kfeng8021-spec/dase7503_robot/maps/before_after_compare.png

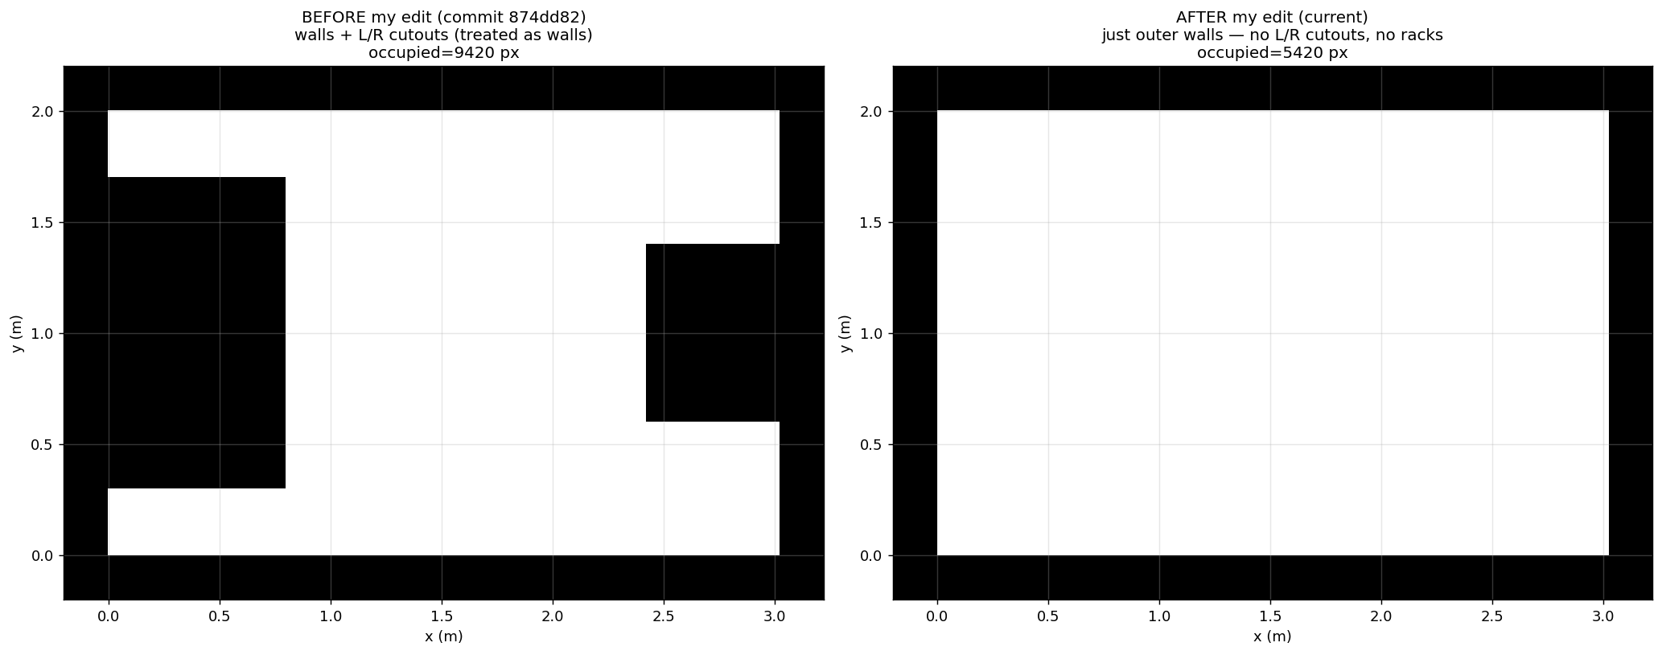
maps/before_after_compare.png
