kfeng8021-spec/dase7503_robot/maps/cad_v3_clean.png

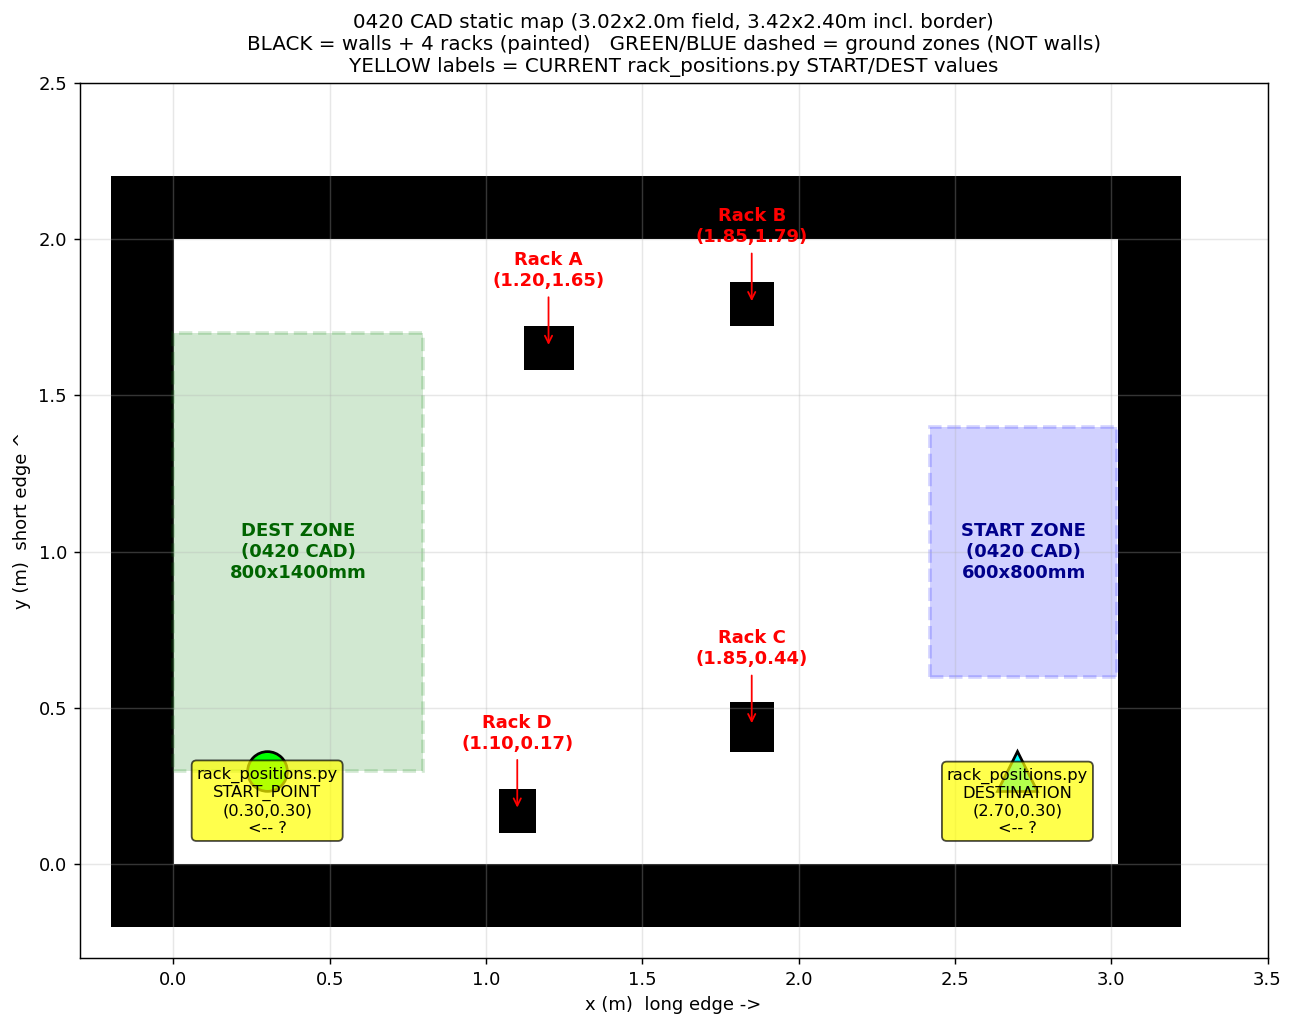
maps/cad_v3_clean.png
