kfeng8021-spec/dase7503_robot/maps/cad_v3_fixed.png

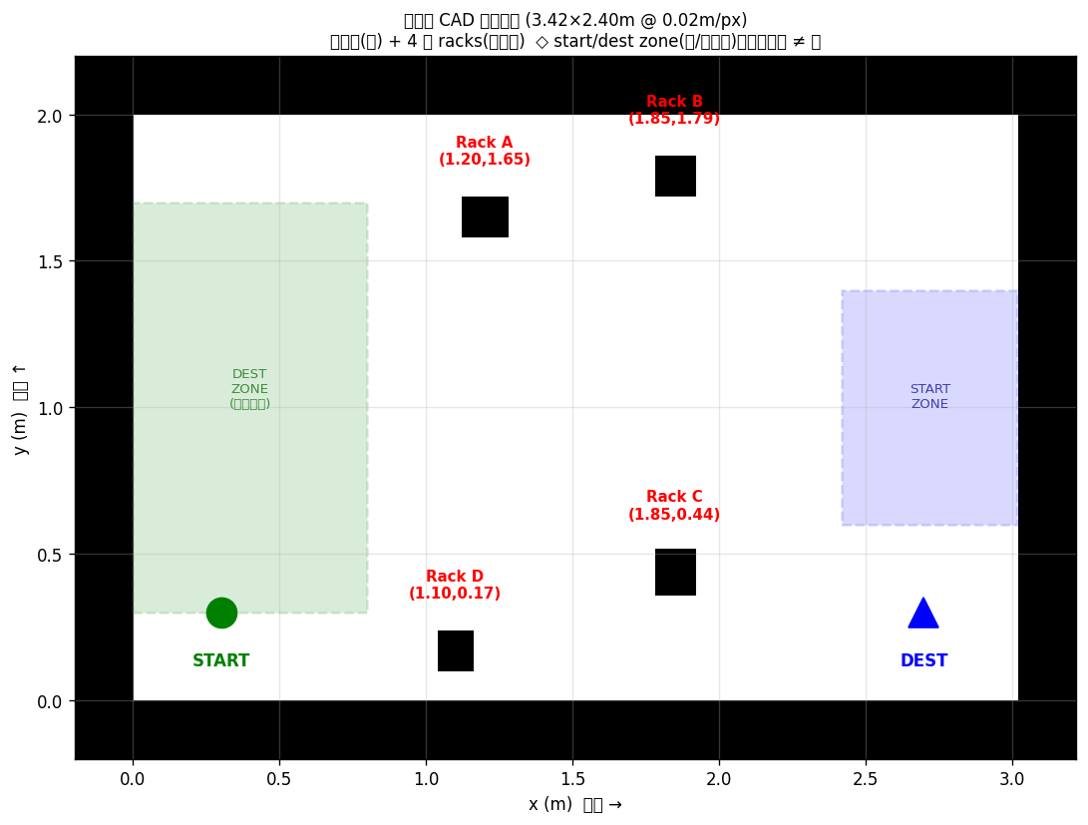
maps/cad_v3_fixed.png
