kfeng8021-spec/dase7503_robot/maps/cad_v4_no_rack_paint.png

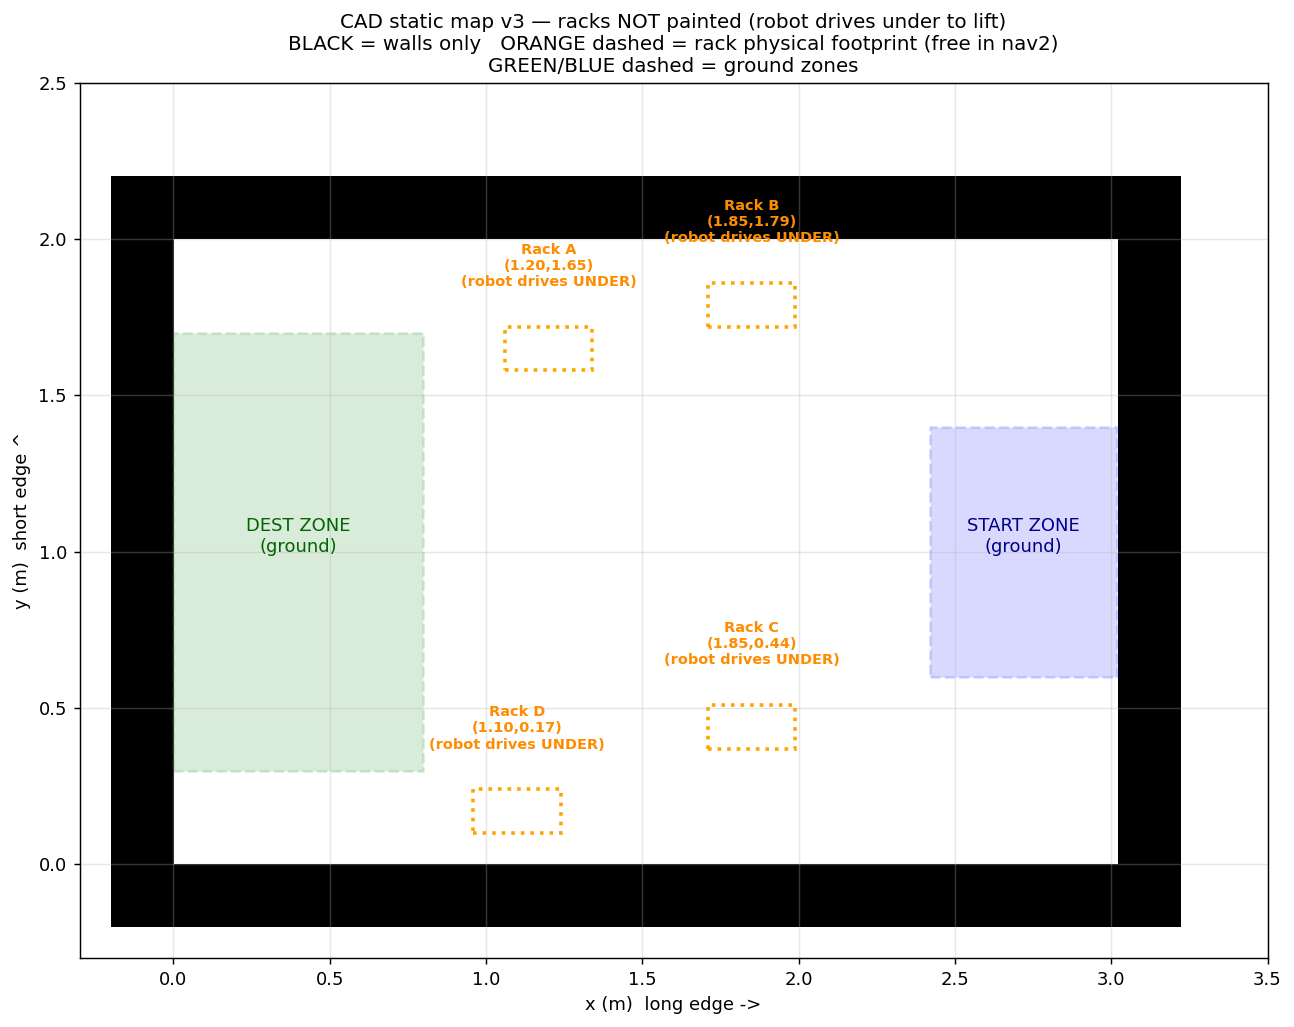
maps/cad_v4_no_rack_paint.png
