kfeng8021-spec/dase7503_robot/maps/cad_with_racks_overlay.png

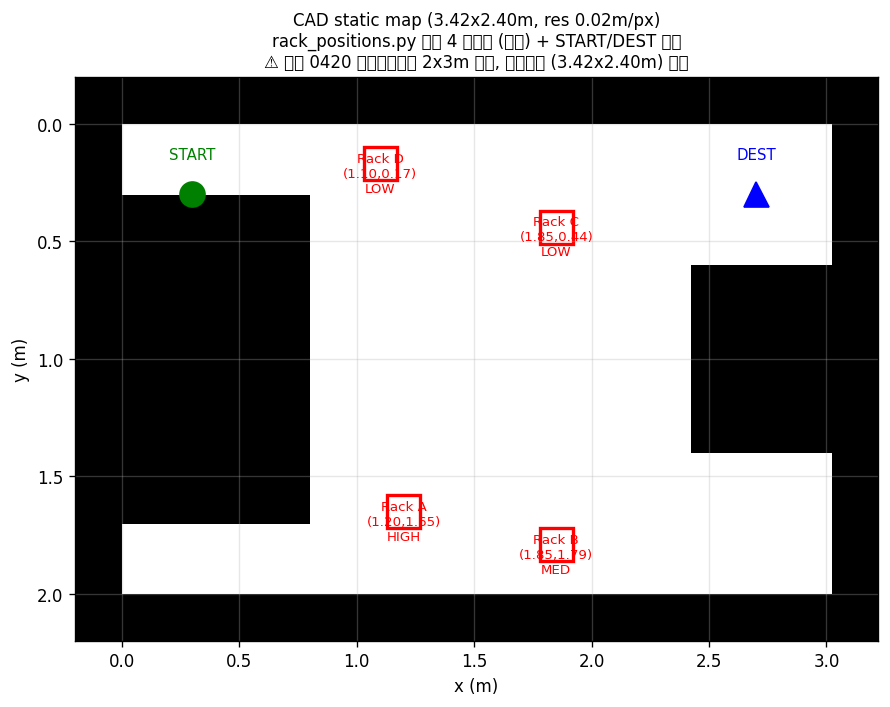
maps/cad_with_racks_overlay.png
