kfeng8021-spec/dase7503_robot/maps/cad_with_racks_v2.png

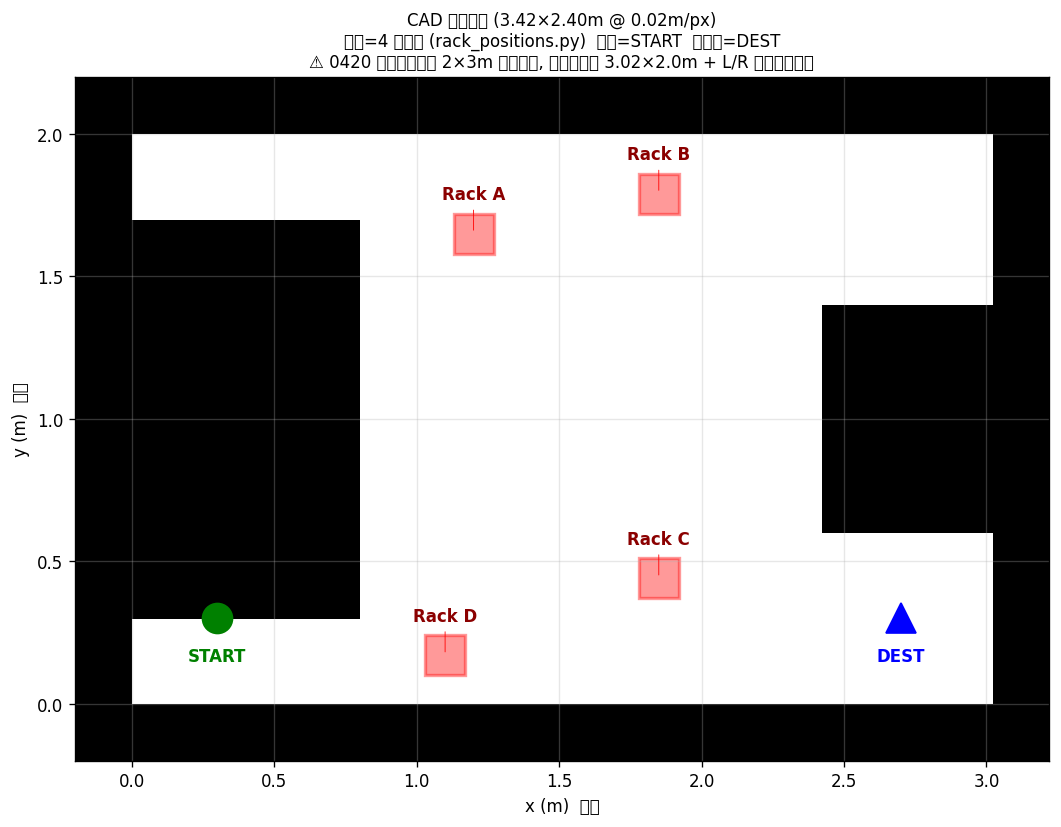
maps/cad_with_racks_v2.png
