kfeng8021-spec/dase7503_robot/maps/pi5_slam/pi5_slam_map.png

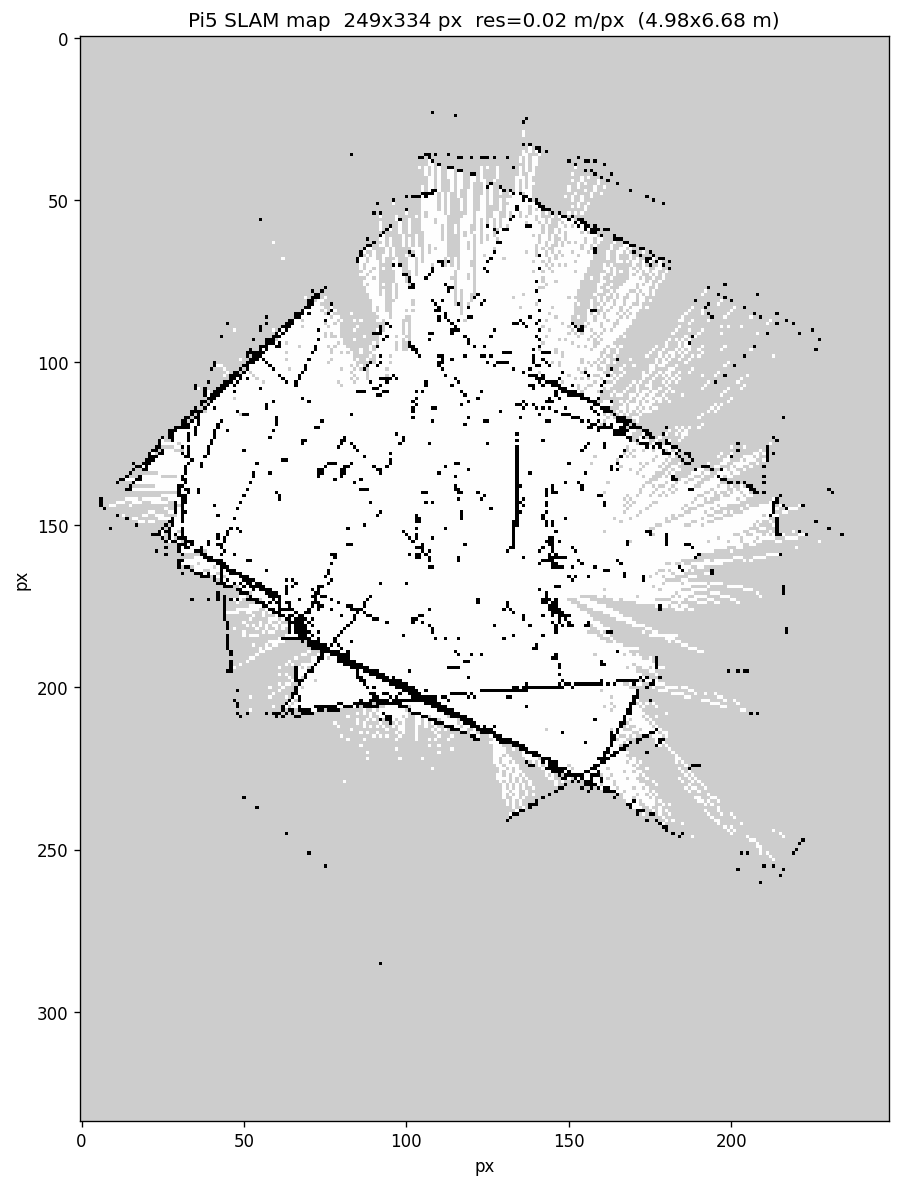
maps/pi5_slam/pi5_slam_map.png
