kfeng8021-spec/dase7503_robot/maps/pi5_slam/slam_vs_cad_with_racks.png

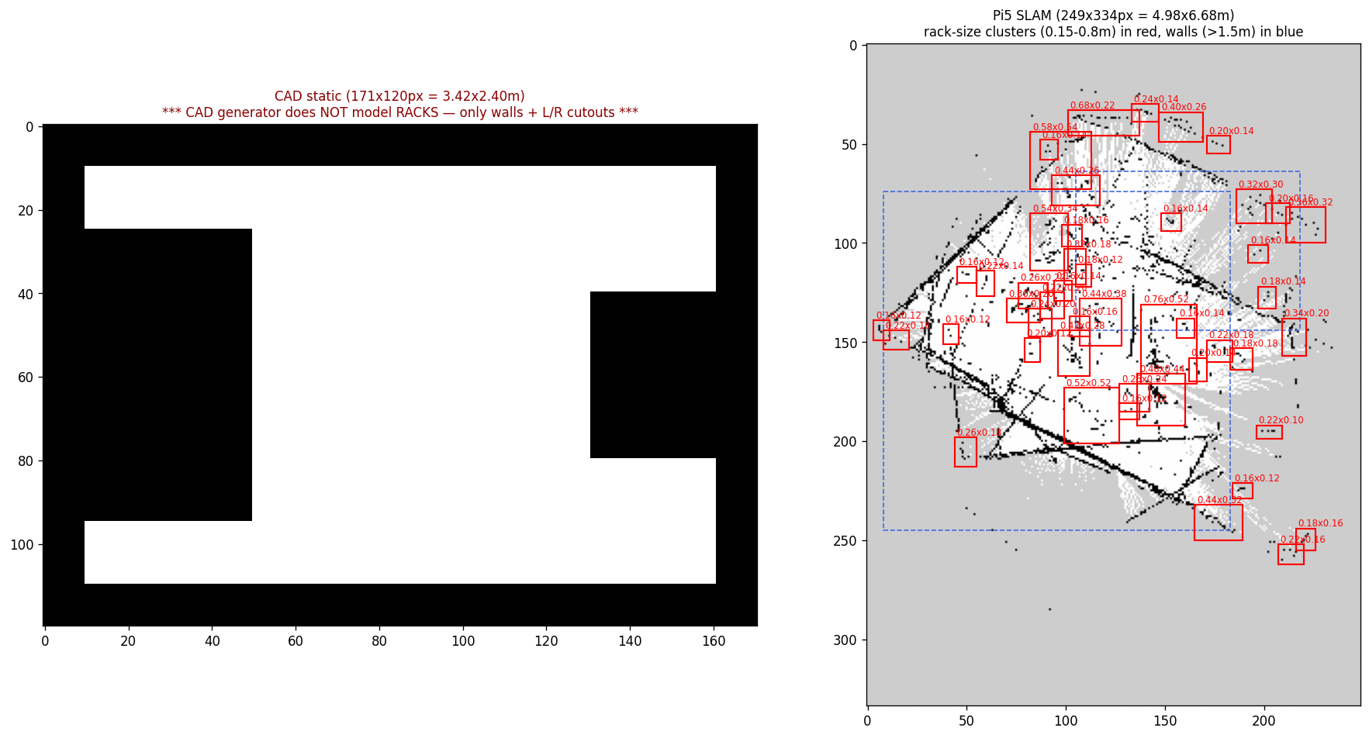
maps/pi5_slam/slam_vs_cad_with_racks.png
