kfeng8021-spec/dase7503_robot/maps/pi5_slam/slam_zoom_clusters.png

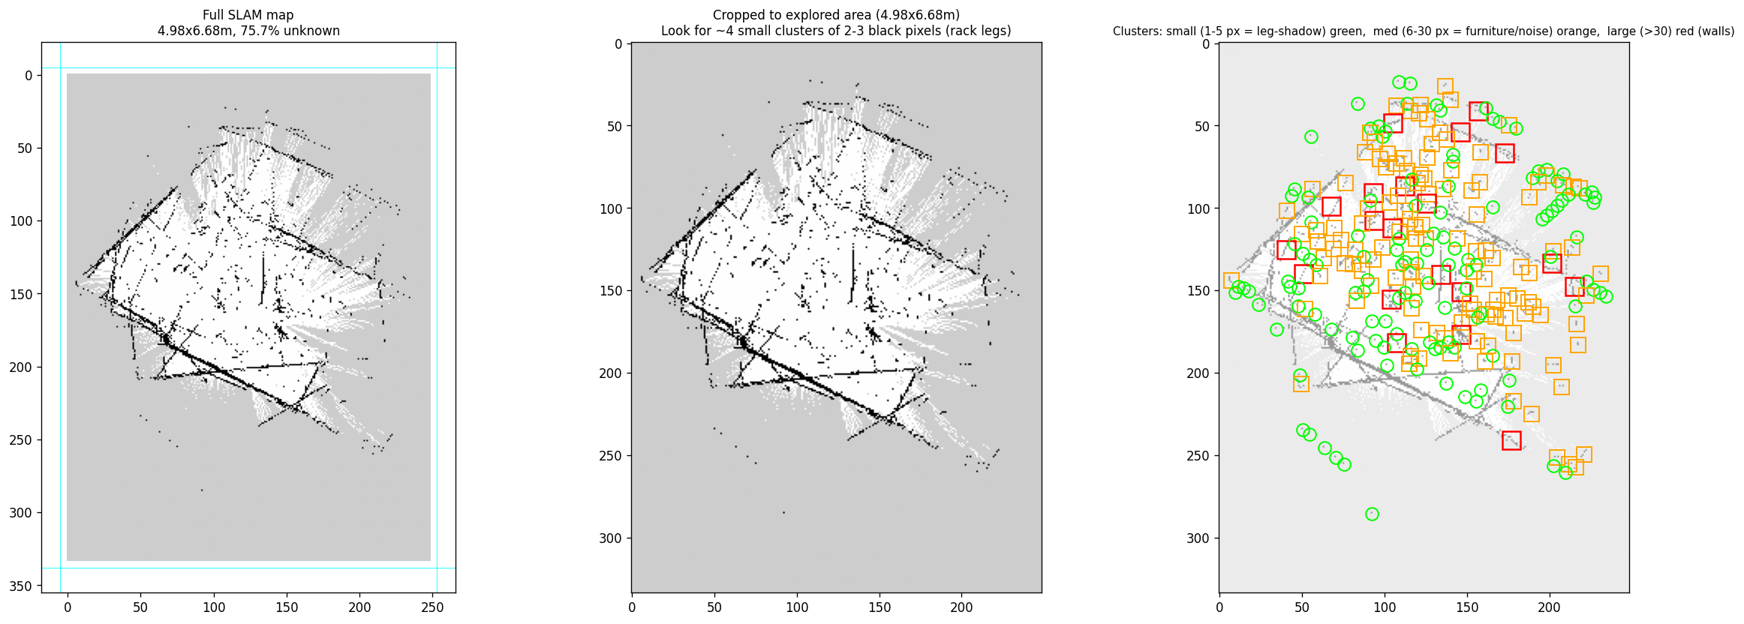
maps/pi5_slam/slam_zoom_clusters.png
