kfeng8021-spec/dase7503_robot/scripts/qr_codes/print_sheet.pdf

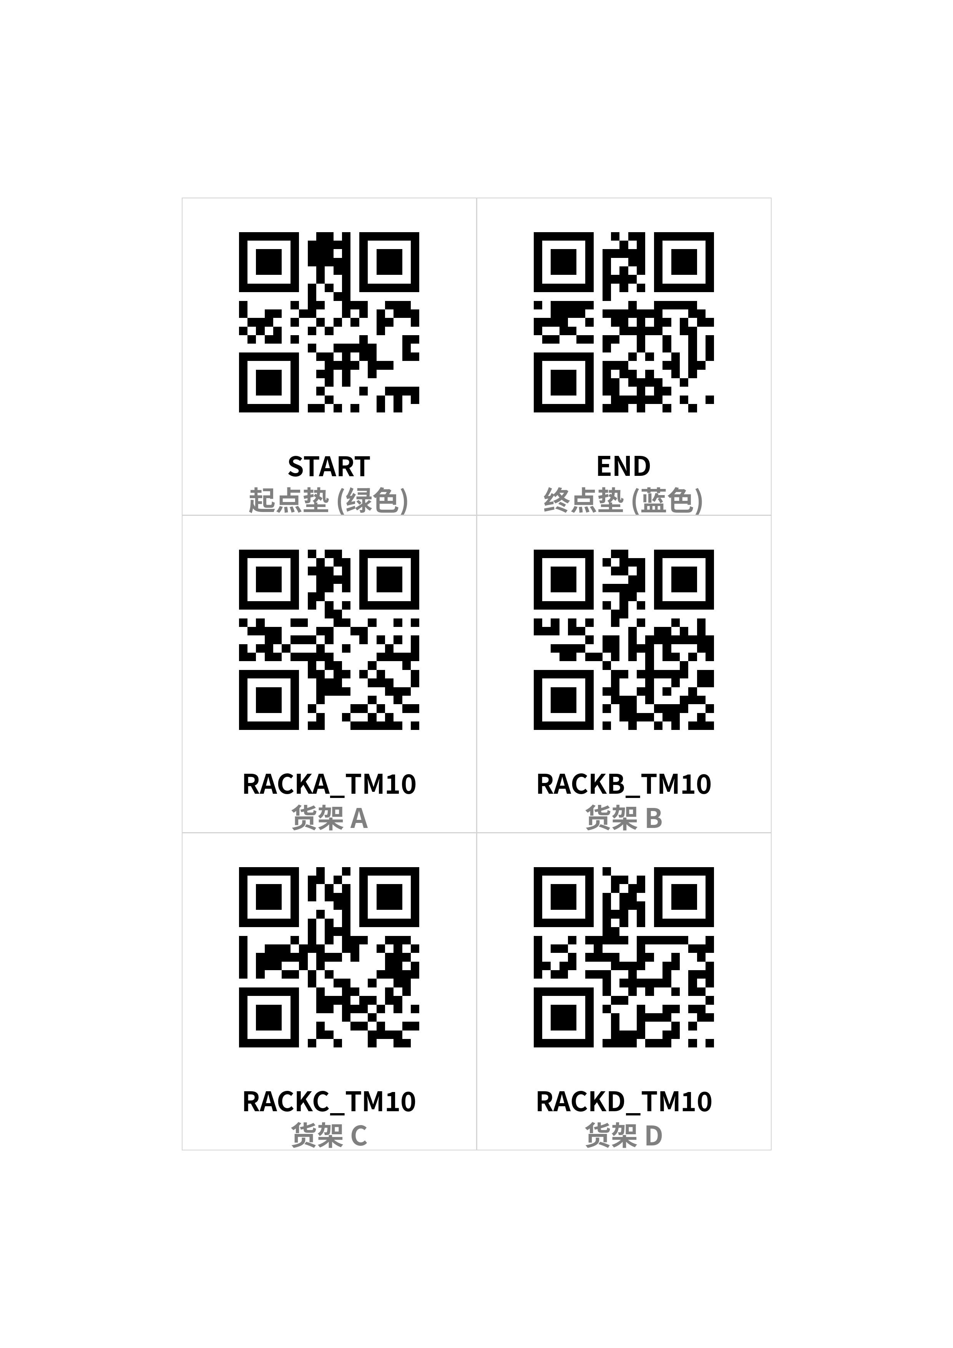
[picture p11: page 1]
