kfeng8021-spec/dase7503_robot/(commit log)

2026-04-21 Initial project scaffold
    - Full Plan 模块骨架: ROS 包 (mission_fsm + qr_scanner), ESP32 固件, nav2 配置
    - Mission FSM 已加入 QR 时间戳记录 (新版比赛要求 2026-04)
    - QR 生成脚本 + 6 张 PNG (队伍串 4X6M)
    - RPi5 Ubuntu 24.04 一键部署脚本
    - 部署笔记 + 8 min 演讲大纲 (含市场/商业/财务)
    - 文档整合 (Full Plan + v2 + Demo + Camera setup + Gamefield)
2026-04-21 Complete scaffold: URDF, SLAM, manual mode, battery, systemd, presentation
    模块 B (ESP32):
    - 新增 /battery_voltage 发布者 (ADC + 分压)
    - 1Hz 电池电压上报
    模块 C/D (Pi5 ROS):
    - 新增 URDF (Mecanum 底盘 + LiDAR 塔 + 相机 + 升降叉)
    - 新增 battery_monitor_node (滞回告警, 6.8V/6.4V 阈值)
    - 新增 manual_mission_node (B range 手动模式, 仍记 QR 时间戳)
    - 新增 slam_toolbox_params.yaml + SLAM 建图 launch
    - 新增 calibration launch + robot_manual launch
    - 新增 robot_view.rviz (TF+Map+LaserScan+Camera+Costmap)
    - robot_full.launch.py 完整化 (加入 battery + URDF state publisher)
    部署自动化:
    - systemd: micro-ros-agent.service + robot.service (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
    [robot.urdf.xacro]
2026-04-21 ESP32 firmware fixes: LEDC 20kHz PWM + ADC init + encoder mult docs
    - 用 LEDC (Arduino Core 3.x API) 替换 analogWrite
    - PWM 频率 20kHz 消除电机 5kHz 嘶叫
    - 8-bit 分辨率 = 0-255 跟 PID 输出一致
    - ADC 显式初始化 analogReadResolution(12) + 11dB 衰减
    - 编码器 CPR 计算: 默认 ENC_MULT=1 (只触发 A 的 RISING, CPR=260)
    - 之前按 CPR=1040 计算, 跟 ISR 实际 1 倍频不匹配
    - 要 4 倍频改 ENC_MULT=4 + 扩展 ISR 到 CHANGE 边沿
2026-04-21 Complete Nav2 TF chain: odom_tf_broadcaster + launch integration
    问题: ESP32 发 /wheel_odom 话题但不发 TF, Nav2 缺 odom->base_footprint 这条 TF 链.
    修复: 新增 odom_tf_broadcaster 节点订阅 /wheel_odom 广播 TF.
    TF 树 (完整):
    map --(AMCL)--> odom --(odom_tf_broadcaster)--> base_footprint
    --(URDF static)--> base_link --> laser_link / camera_link / wheels
    同步更新:
    - setup.py 加 entry_point
    - package.xml 补 tf2_ros / robot_state_publisher / xacro 依赖
    - robot_full.launch.py + slam_mapping.launch.py 加入 odom_tf
    - slam_mapping.launch.py 的 URDF 路径修正 (xacro Command)
2026-04-21 Remove non-robot content (PPT, business/finance plan)
    删除跟小车实战无关的内容:
    - docs/presentation_outline.md (演讲大纲)
    - docs/presentation_content.md (市场/商业/财务 PPT 稿)
    - docs/Demo and Presentation.pdf (演讲安排 PDF)
    同步更新 README:
    - 移除团队分工表里 PPT+商业 一行
    - 仓库结构去掉 presentation_*.md
    - Deadline 列表去 PPT
    - 首屏链接从 Presentation 改成 Wiring / PID tuning
    保留 (全部跟机器人直接相关):
    - game_field.md: 赛场尺寸 + QR 布置
    - wiring.md: GPIO + 电源 + 布线
    - pid_tuning.md: Ziegler-Nichols 调参
    - deployment_notes.md: 时间线 + 网络 + SOP + 验收标准
    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
2026-04-22 Align with Tutorial 7: cv2.QRCodeDetector + CompressedImage + YOLO
    关键对齐老师 Tutorial 7 教学:
    1. qr_scanner_node.py 重写:
    - pyzbar → cv2.QRCodeDetector (OpenCV 自带, Tutorial 7 用的)
    - /camera/image_raw (Image) → /camera/image_raw/compressed (CompressedImage)
    - QoS: RELIABLE → BEST_EFFORT depth=1 (Tutorial 7 标准图像流 QoS)
    - 保留 CLAHE 对比度增强 + 3 帧确认抗误识别
    2. 新增 yolo_detector_node.py (Tutorial 7 第 4 节教的加分项):
    - onnxruntime 跑 yolov8n.onnx, COCO 80 类检测
    - 订阅 /camera/image_raw/compressed, 发布 /yolo/detections/compressed
    - declare_parameter: conf_threshold, iou_threshold, show_window, input_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
2026-04-22 Align ESP32 firmware with Tutorial 5 teaching style
    对齐老师 Tutorial 5 (ROS Programming - Actuators and PID) 的教学风格:
    1. 节点名 micro_ros_node → hku_dase_micro_ros_node (课程指定命名)
    2. Encoder ISR: RISING + digitalRead(B) → CHANGE + 'A==B ? ++ : --'
    - ENC_MULT: 1 → 2 (双边沿倍频, 精度提升)
    - 方向判定方法对齐 Tutorial 5 Page 11
    3. 新增 /set_pid 订阅 (std_msgs/Float32MultiArray [Kp, Ki, Kd])
    - 运行时调 PID 不用重新烧固件
    - 4 电机共用同一组 PID
    - ros2 topic pub --once /set_pid ... '{data: [5.0, 0.3, 0.05]}'
    4. Executor handles 4 → 5 (加了 set_pid 订阅)
    5. GPIO 注释说明: 教学 Tutorial 用 ESP32 Dev M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
2026-04-22 Align with Tutorial 1-4: ros-apt-source + ESP32 Core v2.0.17 LEDC API
    Tutorial 1 对齐:
    - install.sh 改用 ros-apt-source .deb 包方法 (Tutorial 1 教的新版)
    - ROS 2 Jazzy 装 desktop 版 (有 RViz/rqt GUI, 跟 Tutorial 截图一致)
    Tutorial 3/4 对齐:
    - ESP32 Arduino Core 指定 v2.0.17 (老师 Tutorial 3/4 要求的固定版本)
    - LEDC PWM 从 v3.x API (ledcAttach/ledcWrite(pin, duty))
    改回 v2.x API (ledcSetup + ledcAttachPin + ledcWrite(channel, duty)),
    在 v2.0.17 和 v3.x 上都能编译 (v3.x 仅 deprecation warning)
    - firmware README 补充版本指定 + 兼容性说明
    Tutorial 2 (基础教学, 无代码改动):
    - workspace ~/ros2_ws ✓ 匹配我的 install.sh
    - bui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
2026-04-22 Fix ament_python console_scripts location on Ubuntu 24.04
    setuptools 68 + colcon-ros 0.5 在 Ubuntu 24.04 上把 entry_points 装到
    install/our_robot/bin/ 而不是 lib/our_robot/, 导致 ros2 run 找不到节点.
    两处修复:
    - rpi5_setup/install.sh: 集成 symlink 补丁到一键部署流程末段
    - scripts/build.sh: 日常单包迭代脚本 (colcon build --packages-select + 同补丁)
    用途互补: install.sh 首次全栈部署用, build.sh 日常开发只重建 our_robot 用.
2026-04-22 Fix FSM executor blocking + align launch files to /dev/esp32 udev paths
    mission_fsm_node.py (P0 race-day bug):
    - time.sleep(1.5) 在 10Hz timer callback 里阻塞整个 single-thread executor,
    导致 /qr_result 和 NavigateToPose 回调丢失 -> LIFT_UP/LIFT_DOWN 后
    nav_done 永远不置位 -> FSM 卡死.
    改成非阻塞: 用 _lift_cmd_sent flag + _lift_t0 计时, 下个 tick 检查 dwell.
    - wait_for_server() 每次 _nav_to 调一次, Nav2 没起时也会阻塞 timer.
    移到 __init__ 预热一次 (30s timeout), _nav_to 纯 async.
    - SCAN_RACK 状态增加 10s 超时 + 最多 2 次后退 0.15m 重扫. 仍失败则
    跳过该货架 (log SKIPPED_TIMEOUT) 不整场 FSM 挂.
    - 新增 _en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
2026-04-22 ESP32 watchdog + TF frame alignment + real LiDAR udev VID/PID
    ESP32 firmware (safety-critical):
    - 新增 cmd_vel watchdog: 500ms 内没收到 /cmd_vel 强制 target_rpm=0 + pid reset.
    原因: agent / USB / Pi5 任一中断时, 最后一次 target_rpm 会持续驱动电机,
    机器人会失控跑出赛场 (比赛事故).
    - 将 /wheel_odom.child_frame_id 从 "base_link" 改成 "base_footprint",
    与 odom_tf_broadcaster 广播的 odom -> base_footprint TF 对齐, 避免 Nav2
    AMCL 看 Odometry 消息找错 frame.
    udev rules:
    - LiDAR 规则填入实测 VID/PID (CH343 1a86:55d4) 和 serial 597C003280.
    之前是占位 CP210x 10c4:ea60 + "按实际 VID/PID 修改" 注释.
    README:
    - 队伍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
2026-04-22 Align repo with real hardware: Oradar LiDAR + CP2102 ESP32 + source-build micro_ros_agent
    实车硬件探测后的协调修复:
    udev rules (rpi5_setup/udev/99-robot-devices.rules):
    - ESP32 VID/PID 从 CH340 1a86:7523 (早期板子猜测) 改为实测 CP2102 10c4:ea60.
    Yahboom MicroROS-Board ESP32-S3 用的是 CP2102 USB-UART 桥, lsusb 验证.
    - LiDAR 继续 CH343 1a86:55d4 serial 597C003280 (Oradar MS200 实测).
    - 删掉过时的 "如果用 CP2102 取消注释" 备用行.
    LiDAR 驱动切换 (ydlidar → oradar_lidar):
    - 实车用的是 ORADAR MS200, 不是 YDLiDAR. 用户 ros2_ws 里有 oradar_lidar 包.
    - robot_full.launch.py / slam_mapping.launch.py 改 FindPackageShare("oradar_lidar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
2026-04-22 Switch ESP32-S3 firmware to PlatformIO (micro_ros_arduino v2.0.8 不支持 S3)
    问题:
    micro_ros_arduino v2.0.8-jazzy 的 precompiled libmicroros.a 只打包了原版
    ESP32 (Xtensa LX6) 架构的二进制, src/ 目录下没有 esp32s3 子目录. 曾尝试把
    src/esp32/libmicroros.a 复制成 src/esp32s3/libmicroros.a 蒙混 — 编译链接过了
    (LX7 向下兼容 LX6 的通用 ISA), 但运行时 micro-XRCE 内部用到 chip-specific 的
    peripheral / cache register 地址, 在 S3 上炸 (串口零 XRCE bytes 出).
    方案:
    新增 firmware/esp32_pio/ (PlatformIO 项目结构), 保留 firmware/esp32/ 的
    Arduino IDE .ino 作为参考历史. 代码相同, 只改 include + transport API:
    - #incl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
    [main.cpp]
2026-04-23 Fix systemd user hardcoding + PIO firmware corrections
    systemd:
    - micro-ros-agent.service / robot.service User=dase -> {{USER}} 占位
    - install_systemd.sh 动态按 $SUDO_USER 替换 User/HOME
    - 修硬编码用户导致 status=217/USER 的问题
    PlatformIO ESP32-S3:
    - build_unflags 剔除 board json 硬编的 ARDUINO_USB_MODE=1
    - flash_size 8MB -> 4MB (Yahboom 实测)
    main.cpp motor_armed 保护:
    - cmd_vel 500ms 内新鲜 + 过了 grace period 才通电
    - 防止 agent 断开或开机瞬间电机失控转飞
    .gitignore: firmware/esp32_pio/.pio/
    [main.cpp]
2026-04-23 ESP32 firmware: 4 层安全限幅 + /emergency_stop 话题
    保护层 (从输入到输出):
    1. 输入: cmd_vel 速度硬限幅
    - linear x/y: ±0.20 m/s (从 Full Plan 目标 0.3 的 2/3, 慢速 bench)
    - angular z: ±1.0 rad/s
    2. 运算: target_rpm 硬限幅 ±80 RPM (约 0.27 m/s 输出轮速)
    3. 输出: PWM duty 硬限幅 180/255 ≈ 70% (防 PID 饱和暴冲)
    4. 急停: /emergency_stop (std_msgs/Bool) 话题
    - pub true 立刻 PWM=0 + target_rpm=0 + PID reset + 锁死
    - pub false 解除
    实车 bench test 通过 + PID 调稳 + 方向对了后, 可把 MAX_* 和 PWM_CAP
    常量逐步放开到 Full Plan 目标:
    MAX_LINEAR_VEL 0.20 -> 0.30
    MAX_TARGET_RPM 80 -> 150
    PWM_CAP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
    [main.cpp]
2026-04-23 teleop 避障模式: laser_safety_node 前置 gate + launch
    新增第三种运动模式 (手动遥控 + LiDAR 避障), 补齐原方案只有 Nav2 自主 / 裸遥控两档的缺口.
    - laser_safety_node.py (161 行): 订阅 /cmd_vel_raw + /scan, 发布 /cmd_vel. Mecanum 三轴独立扇区 (±30°) 最近距离检查, hard_stop=0.25m slow_down=0.5m 线性缩放, wz 只在全周安全时允许, 0.5s watchdog 无新 cmd_vel_raw 归零.
    - teleop_avoid.launch.py (84 行): 启动 sllidar + laser_safety_node, lidar_dev/hard_stop_dist/slow_down_dist 作为 launch 参数.
    - setup.py: 注册 laser_safety_node entry.
    - udev 99-robot-devices.rules: LiDAR 规则不再锁 serial number (本机唯一 CH343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
2026-04-24 teleop 避障: LiDAR 走 Pi5 USB + /scan_lidar 隔离 ESP32 空数据
    **setup.cfg (新建)**: ament_python 入口脚本必须安装到 lib/<pkg>/ 才能被 ros2 launch 找到.
    原来缺这个文件, colcon build --symlink-install 把脚本装到 install/our_robot/bin/,
    导致 `ros2 launch` 报 "executable 'laser_safety_node' not found on libexec directory".
    这是根因 — 所有 entry_point node 都受影响, 不止 laser_safety_node. (Python 3.12 +
    setuptools 新默认路径放 bin/, 旧版本有时碰巧走 lib/.)
    **teleop_avoid.launch.py**:
    - 恢复启动 oradar_lidar (课程材料 2.1 明确要求 LiDAR 接 Pi5 USB, 不走 ESP32 板上口).
    改用内联 Node 定义 (不 IncludeLaunc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
2026-04-24 slam/nav2: 统一订 /scan_lidar, 清理自启 agent
    延续上一 commit (5802ee0) 的架构: ESP32 factory FW 永远发 /scan (板上 LiDAR 口空则 ranges 全 0),
    所以 oradar_lidar 走 /scan_lidar, 所有下游也订 /scan_lidar.
    改动:
    - slam_mapping.launch.py: IncludeLaunchDescription(ms200_scan) 改为内联 Node 覆盖
    scan_topic=scan_lidar. 去掉 ExecuteProcess 自启 agent (和 systemd 冲串口).
    - robot_full.launch.py: 同上处理 (lidar 内联 + 去 agent).
    - slam_toolbox_params.yaml: scan_topic: /scan → /scan_lidar.
    - nav2_params.yaml: amcl 加 scan_topic: /scan_lidar.
    **未改 (留到能地面测再改)**:
    - Nav2 local/global costmap 的 obstacle_layer.scan.topic 仍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
2026-04-24 nav2: costmap obstacle_layer 显式订 /scan_lidar
    接 d467356 的遗留 TODO — local/global costmap 的 obstacle_layer.scan.topic 必须显式
    指向 /scan_lidar, 不能依赖 Nav2 默认的 /scan (会吃到 ESP32 factory FW 的空数据).
    改 nav2_params.yaml:
    - local_costmap: plugins=["obstacle_layer", "inflation_layer"]
    obstacle_layer.scan.topic=/scan_lidar, sensor_frame=laser_link,
    raytrace_max_range=3.0, obstacle_max_range=2.5
    inflation_layer.inflation_radius=0.15 (从顶层搬进来)
    - global_costmap: plugins=["static_layer", "obstacle_layer", "inflation_layer"]
    obstacle_layer 同上, inflation_layer.inflation_radius=0.20
    **未验证运行时行为**: 当前没有 ~/maps/g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
2026-04-24 slam_mapping 端到端跑通 + 修 /wheel_odom 命名残留
    修复 4 处阻止 slam_mapping.launch.py 跑通的问题:
    1. odom_tf_broadcaster.py: 原订 /wheel_odom (团队 PIO 固件命名), 工厂 FW 发的是 /odom_raw.
    切到 /odom_raw, 对齐工厂 FW. (团队 PIO 已废弃, 见 project memory.)
    2. slam_mapping.launch.py + robot_full.launch.py: robot_state_publisher 的
    robot_description 参数 ROS 2 Jazzy 要显式 ParameterValue(value_type=str) 包一下,
    否则 launch 报 "Unable to parse the value of parameter robot_description as yaml".
    3. slam_mapping.launch.py: async_slam_toolbox_node 是 lifecycle 节点, 手写 Node()
    不会 auto-configure+activate, 会卡在 unc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
2026-04-24 slam: minimum_travel_distance 0.2→0.0 方便悬空/原地验证
    原 0.2m / 0.2rad 阈值要求车体移动才触发 scan 注册, 悬空测试时 slam 看不到 odom
    移动 → 拒绝所有 scan → /map 永远空.
    改成 0 后, 每帧 scan 都处理, 悬空原地也能出地图 (这次验证: 184×191 cells @ 2cm).
    部署到赛场真建图时按需改回 0.2 — 真动起来时太敏感会产生太多 keyframe 拖慢.
2026-04-24 robot_full: 把 yolo_detector 并入 launch
    之前 robot_full.launch.py 启 camera + qr_scanner, 但 yolo_detector_node.py 的
    entry 在 setup.py 注册了却没实际启. 加进去.
    - yolo_detector: 订 /camera/image_raw/compressed, 发 /yolo/detections/compressed.
    用 onnxruntime CPU provider + yolov8n.onnx (已 install 到 share/our_robot/models).
    - 和 qr_scanner 共用 /camera/image_raw/compressed, 互不冲突.
    - output=log (不抢 screen, 只在检测到物体时记 info).
    验证 (悬空测试, 无 camera):
    ros2 run our_robot yolo_detector_node
    → "Loading ONNX: .../yolov8n.onnx"
    → "YOLO detector ready."
    (等 /camera/image_raw/compressed, 但 camera 硬件现在 I2C 通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
2026-04-24 README: 刷新到 2026-04-24 实际架构 (工厂 FW + /scan_lidar + YOLO)
    昨天 (4/24 晚) + 今天的架构变化让 README 6 处严重过时:
    1. ESP32 烧录: Arduino IDE + 团队代码 → Yahboom 工厂固件 V2.0.0 (esptool 刷)
    2. 波特率: 115200 → 921600 (工厂 FW 硬编码) + ROS_DOMAIN_ID=20
    3. 话题表重写:
    - /wheel_odom → /odom_raw
    - /lifter_cmd → /servo_s2 (-90..20)
    - /battery_voltage (Float32) → /battery (UInt16, data÷10=V)
    - /scan + /scan_lidar 双 topic 说明 (ESP32 空数据 vs oradar 真数据)
    - 加 /cmd_vel_raw, /yolo/detections/compressed
    4. udev VID/PID: CH340 1a86:7523 → CP210x 10c4:ea60 (ESP32) + CH343 1a86:55d4 (LiDAR)
    5. YOLO: "默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
2026-04-24 FSM/manual/battery: 对齐工厂 FW topic + 升降角度 + 8 分钟 budget
    阻止比赛挂的 3 个问题, 在赛前必须修:
    P1. /lifter_cmd → /servo_s2 (3 处):
    原 /lifter_cmd 是团队 PIO 固件的 topic, 工厂 FW 不订 → 升降永不动作.
    改成工厂 FW 的 /servo_s2. 影响: mission_fsm_node, manual_mission_node.
    P2. 升降命令从 0/1 二值 → servo 角度 -90..20:
    工厂 FW 的 /servo_s2 是 Int32 角度 (-90..20 度), 不是开关.
    新增 LIFT_UP_DEG=20, LIFT_DOWN_DEG=-90 模块常量, 赛前用 manual_mission_node
    的 u/d 键校准到机械实际位置 (可能需要针对叉臂几何调整).
    P3. /battery_voltage Float32 → /battery UInt16 (data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
2026-04-24 场地地图: 从课程 CAD 尺寸直接生成, 省掉 SLAM 不确定性
    scripts/generate_static_map.py:
    从课程 PDF "DASE7503 Group Project_QR Code and Gamefield.pdf" 图 2 的 CAD 俯视图
    硬编码尺寸 (3020×2000 mm 场地 + 左 800×1400 / 右 600×800 两块突入墙体), 生成
    Nav2 兼容的 OccupancyGrid PGM + YAML.
    maps/gamefield_map.{pgm,yaml}:
    171×120 px @ 2cm/px (包含 10px 缓冲边).
    原点 (0,0) = 场地左下角, +x 沿长边 3.02m, +y 沿短边 2.0m.
    Nav2 / AMCL 可以直接加载这个 map 做定位, 不用赛前 SLAM.
    为什么这么做:
    - CAD 是"真值", 实物按 CAD 制造, 比 SLAM 建图没漂移
    - 原方案 rack_positions.py 坐标是 Full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
2026-04-24 rviz config: /scan → /scan_lidar (跟 d467356/5802ee0 的 topic 重命名对齐)
2026-04-24 rack_positions + FSM: 从课程 CAD 图填坐标 + 改回 3 分钟 budget (按 0420 规则)
    1. MISSION_BUDGET_SEC 8*60 → 3*60 — 0420 Group Project doc "Within 3 minutes" 为准
    (之前用 8min 是被 latest/Demo PDF 的 "8 minutes" 误导)
    2. rack_positions.py 从 CAD (Gamefield PDF 图 2 俯视图) 填充货架中心坐标:
    A (上左中): (1.20, 1.65) HIGH — CAD 400/350 直接读
    B (上右): (1.85, 1.79) MED — Y 210 直接读, X 从 650 中心间距推
    C (中右): (1.85, 0.44) LOW — 650/440 组合解释有多种可能
    D (下中左): (1.10, 0.17) LOW — 450/350/130 组合
    3. DEST + START CAD 没画坐标, 按物理照片占位 (blue=dest, gr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
2026-04-24 队伍 code 定稿 TM10: 生成 6 张 QR PNG + 更新 FSM 匹配
    QR 内容:
    START / RACKA_TM10 / RACKB_TM10 / RACKC_TM10 / RACKD_TM10 / END
    打印流程:
    1. scripts/qr_codes/*.png 每张 ~8x8 cm 打印
    2. 贴对应位置 (A→货架A, START→起点垫子, 等)
    3. 比赛时复用, 不消耗
    删了老的 RACK*_4X6M.png, START / END 不变 (队伍无关).
2026-04-24 清理老的 RACK*_4X6M.png (已被 0670858 的 TM10 版替代)
2026-04-24 QR 打印排版: 6 张 QR 排一张 A4 (带中文标签)
    scripts/qr_print_layout.py: A4 竖版 2x3 grid, 每张 QR 75mm, 下面 CJK 标签标明贴哪里
    (START → 起点垫, END → 终点垫, RACKA_TM10 → 货架 A, ...).
    输出 scripts/qr_codes/print_sheet.{pdf,png} 可直接打印, 剪下来贴.
2026-04-25 qr_scanner: 加 pyzbar fallback + 多尺度 + 空帧防御
    实测 (2026-04-25):
    - 原 scanner 只用 cv2.QRCodeDetector (Tutorial 7 教法), 在 IMX708 远距小 QR 上识别率低
    - 加 pyzbar 兜底, 实测 cv2 失败的同帧 pyzbar 直接成功
    - 再加 2x / 3x upscale 兜底, 处理 ~80x80 像素以下的小 QR
    - callback 加空 buffer 防御 (cv2.imdecode 在 msg.data 空时会 assertion)
    成功验证:
    - 距离 ~30-50cm, QR 正对相机, 连续 5+ 帧解出 RACKB_TM10
2026-04-25 nav2: AMCL OmniMotionModel → DifferentialMotionModel
    工厂 FW 不支持 Mecanum 横移 (vy 命令被忽略, 我们今天 2026-04-25 实车验证过).
    AMCL 之前配的 OmniMotion 假设车能任意方向运动, 跟实车不符 → 粒子分布发散,
    定位精度差, 收敛慢.
    改成 DifferentialMotionModel 后 AMCL 按差速假设传播粒子 (只前进 + 旋转),
    和实车行为一致, 定位精度和收敛速度都好.
2026-04-26 实车校准: LIFT 方向实测反转 + slam keyframe 生产值 + static map 不画 rack/zone
    - manual_mission_node + mission_fsm_node: LIFT_UP=-90 / LIFT_DOWN=+20
    (实测发现 servo_s2 极性和 README 反, 之前的注释是错的)
    - slam_toolbox_params: minimum_travel 0.0/0.0 → 0.1m/0.15rad (8.6°)
    (悬空测试值改回实车 keyframe 触发阈值)
    - generate_static_map: 删除 left/right cutout 作为 occupied 的逻辑
    (那两块是 destination/start 地面 marked 区, 不是物理墙;
    rack 是拱形门框机器人要钻进去托起, 也不能画 occupied)
2026-04-26 tools+maps: rviz_remote / servo_tune 实测工具 + CAD/SLAM 参考图
    - scripts/rviz_remote.sh: 本机 RViz 订阅 Pi5 (172.20.10.9) 的 /map /scan_lidar /tf
    (cyclonedds + DOMAIN_ID=20, 配 robot_view.rviz)
    - scripts/servo_tune.py: 实时键控调舵机 (j/k/u/i/h/l ±1/5/10°),
    支持 /servo_s1 (-90..+90) 和 /servo_s2 (-90..+20) 切换, 用来校准 LIFT 极限位
    - maps/cad_*.png: CAD 场地图迭代 (v2/v3 含 rack 标记 → v4 删 rack 涂层)
    - maps/before_after_compare.png: 修正前后静态地图对比
    - maps/pi5_slam/: Pi5 跑 slam_toolbox 的实采输出 (yaml + 3 张可视化)
2026-04-26 third_party: 加 camera_ws 能跑的 libcamera (rpi fork) + camera_ros + qr_detector
    Pi5 上 ros-jazzy-camera-ros + ros-jazzy-libcamera 0.7.0 (apt 装的) 在 PiSP pipeline
    上 acquire CFE 失败 ("no cameras available"). 用 ~/camera_ws 里用户预编译的
    raspberrypi/libcamera fork (commit fe601eb6) + christianrauch/camera_ros (03c9e03)
    加 libpisp 才能跑通. 锁住已验证可用的 commit, 防止 upstream 漂移.
    qr_detector.py 是 Group10 的 vision node (订阅 /camera/image_raw, 发 /qr_result).
2026-04-26 qr_detector: ~/camera_ws/qr_detector.py 集成成 our_robot package node
    - qr_detector_node.py (Group10 自己的版本, 订阅 /camera/image_raw Image, pyzbar 解码
    START/END/RACK[A-D]_*, 发布 /qr_result + 保存 G10_Evidence_*.png)
    - setup.py 加 console_scripts entry: qr_detector_node
    - qr_detect.launch.py 启动 camera_ros::camera_node + qr_detector_node
    - 老的 qr_scanner_node 保留作 fallback (订阅 compressed image), 不动
    跟 third_party/{libcamera,camera_ros} submodule 一起, 形成 ws → our_robot 的迁移闭环.
2026-04-26 qr_detector_node: 加 5s 去重避免 30fps 刷屏 mission_fsm
    实测 camera 30fps + pyzbar 解码每帧成功 → /qr_result 被同 QR spam 30 次/秒,
    mission_fsm 状态机会被快速触发. 加 (data, int(time/5)) 5s 窗口去重, 跟
    manual_mission_node._qr_cb 完全一致的逻辑. captured_list 保存证据图的去重
    不变 (永久去重整次任务).
2026-04-26 坐标系: +x→2000mm 短边水平 / +y→3020mm 长边垂直 + rack 全部重读
    之前 generate_static_map.py 写 +x=长边 3020 / +y=短边 2000, 视觉上 PDF 倒置图
    里 +x 沿垂直方向 (反直觉). 改成 +x 横 +y 纵 (跟 ROS map_frame 标准 + 0420 CAD
    图直觉对齐).
    修改清单:
    - generate_static_map.py: FIELD_W/H 互换 (W=2000 沿 x, H=3020 沿 y), 注释更新
    - rack_positions.py 全部坐标重写 (+x 短 / +y 长 约定):
    * START_POINT = (1.20, 0.30, π/2) start_zone 右半中点 (用户指定初始 lift 位)
    * DESTINATION = (1.00, 2.62, π/2) destination_zone 中心
    * RACK A = (0.30, 1.87) 左上
    * RACK B = (1.00, 0.97) 中下
    * RACK C = (1.56, 1.51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
2026-04-26 rack_positions: 用户实测精确值 (+20mm 容差) 替换我的肉眼估值
    之前 commit 9ba611d 我从图肉眼估的 4 个 rack 中心误差 12-40cm:
    A: 估 (0.30, 1.87), 实测 (0.530, 1.890), Δ 23cm
    B: 估 (1.00, 0.97), 实测 (1.389, 1.180), Δ 39cm ← 错最多
    C: 估 (1.56, 1.51), 实测 (1.693, 1.688), Δ 18cm
    D: 估 (0.26, 0.91), 实测 (0.378, 1.081), Δ 21cm
    也补全:
    - FIELD_WIDTH/HEIGHT 常量
    - RACK_SIZE_X = 0.364m, RACK_SIZE_Y = 0.144m (rack 长×短, 长边沿 x = 机器人钻过方向)
    - DESTINATION_zone 实测 1410×800 (CAD 标 1400, 差 10mm)
    - START_POINT y=0.295 (CAD 估 0.30, 差 5mm)
    confidence 全升 HIGH.
2026-04-26 mission_fsm: SCAN_START 注入 /initialpose 给 AMCL + launch 切到 qr_detector
    之前 mission_fsm 扫到 START QR 只启动 3min timer, AMCL 没人告诉它车在哪 →
    默认 (0,0,0) → 一启动就跑偏. 现在 SCAN_START 时 publish 一次 PoseWithCovarianceStamped
    到 /initialpose, 用 START_POINT (1.20, 0.295, π/2) + 5cm/5° 协方差.
    robot_full.launch.py: qr_scanner_node (compressed) → qr_detector_node (raw image,
    Group10 5s 去重版本). 跟单独跑测试用同一个 node, 行为一致.
2026-04-26 mission_fsm: 加 SCAN_END 状态 + _qr_cb 路上 QR 全 log
    修两个跟 0420 spec 不一致的 bug:
    1. 漏 END QR: 之前 CHECK_DONE 4 个 rack 后直接 FINISHED, 没扫 END.
    PDF 第 1 页明确 "End point QR code should be decoded as END". 加 SCAN_END
    状态: 4 个 rack 搬完后等 self.qr_recv == "END" → log → FINISHED.
    10s 超时强制 FINISHED + log "END=TIMEOUT_NO_QR".
    2. 路上 QR 不进 CSV: _qr_cb 之前只更新 self.qr_recv 不写 CSV, 状态机
    主动 log 漏了路过其他 QR. 改 _qr_cb 增加 (data, time/5) 5s 去重 +
    立即 log workstation="DETECT". 跟 manual_mission_node 一致.
    保留状态机的 _log_qr 调用 (workstation=START/RACK_X/END),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
2026-04-26 rack_positions: START_POINT y 0.295 → 0.298 (用户实测精确值)
2026-04-26 mission_fsm + START: 初始位姿改 yaw=π + IDLE 先 LIFT_DOWN
    - START_POINT yaw 1.5708 (π/2 朝 +y) → 3.14159 (π 朝 -x). 用户实测小车在
    start_zone 右半中点时朝场地左边, 不是直接面对 destination. AMCL 用 π 注入
    initial pose 才跟实际朝向一致.
    - IDLE 状态加 LIFT_DOWN 初始化: 启动时叉臂可能在 UP 位置 (上次任务残留 /
    调试残留, 实测确实如此), 钻 rack 会撞顶板. IDLE 进入时先发 +20° 让叉臂
    落到 DOWN 位置, dwell 1.5s 后再切 SCAN_START.
2026-04-26 nav2_params: planner plugin name '/' → '::' (Nav2 jazzy 期待 ::)
2026-04-26 nav2_params: 加 collision_monitor 最小配置 + 修 inflation_radius 0.15→0.20
2026-04-26 nav2_params: collision_monitor 抄 nav2_bringup 默认配置, 仅改 scan topic
2026-04-26 nav2_params: 加 docking_server 默认配置避免 lifecycle abort (我们没充电桩但 nav2_bringup 强制启动它)
2026-04-26 mission_fsm: init 时立即 publish initial pose (修死锁)
    之前 SCAN_START 扫到 QR 才 publish /initialpose. 但 controller_server.activate()
    等 map frame, map frame 来自 AMCL, AMCL 等 /initialpose → 死锁:
    controller_server 60s 超时 abort → bt_navigator 没起来 → mission_fsm 拿不到
    navigate_to_pose action server → 用户扫码也没用.
    改: __init__ 创建完 pubs 后立即 publish (用 START_POINT 写死值, 反正机器人就在那).
    spin_once 20× 让 publisher 跟 AMCL discovery, 然后 publish 一次. SCAN_START 状态
    保留 _init_pose_sent 守卫, 避免重复 publish.
    扫 START QR 仍然必要 (启动 3min timer + 进 NAV_TO_RACK), 跟位姿初始化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
2026-04-26 robot_full: camera_ros remap /camera_node/* → /camera/* (qr_detector 订阅 /camera/image_raw)
2026-04-26 mission_fsm: 修 _qr_seen AttributeError (init 顺序: state vars 必须在 create_subscription 前)
2026-04-26 nav2_params: collision_monitor 放宽 transform_tolerance 0.2→1.0, source_timeout 1.0→5.0 (硬件 TF 11Hz 跟不上)
2026-04-26 nav2_params: collision_monitor approach polygon enabled=False (一直阻 cmd_vel)
2026-04-26 cmd_vel_relay: 绕过 nav2 velocity_smoother + collision_monitor
    实测 nav2 default cmd_vel chain 卡死: controller_server→cmd_vel_nav→
    velocity_smoother→cmd_vel_smoothed→collision_monitor→/cmd_vel. 整 mission 3min
    controller "Failed to make progress" 车从未动.
    加 cmd_vel_relay_node: subscribe /cmd_vel_nav → publish /cmd_vel. 直发到 ESP32.
    controller_server 内部已有 max_velocity 限制 (RegulatedPurePursuitController),
    不需要再 smooth/saturate.
    代价: collision_monitor 不参与决策 (但我们之前已 enabled=False), velocity_smoother
    不平滑加速度 (controller 自己有 reasonable max_accel). 短期 hack 让车能动起来.
2026-04-26 nav2_params: controller 加 rotate_to_heading_angular_vel=0.6 + min_approach_linear=0.1 (跨 ESP32 motor 死区)
2026-04-26 nav2_params: progress_checker 放宽 0.5m/10s → 0.05m/20s (硬件慢)
2026-04-26 nav2_params: 中等档速度 desired_lin 0.30→0.40, rotate_ang 0.6→0.8, min_approach 0.10→0.15
2026-04-26 mission_fsm: /initialpose 用 transient_local QoS (latched), AMCL 后启动也能拿到 — 修死锁回归
2026-04-26 robot_full: 暂禁 YOLO (Pi5 CPU 跑不动 nav2+camera+yolo, controller 7Hz vs 20Hz fail)
2026-04-26 mission_fsm: SCAN_RACK 改 wildcard 'RACK<id>_*' 匹配 (不绑 TEAM_CODE)
2026-04-26 generate_static_map: 画 rack 立柱 (修 AMCL 漂移)
    实测 mission 时 AMCL 收 initial pose (1.20, 0.298, π) 后, first LiDAR scan 立刻
    跳到 (0.754, -0.069, 60°). 因为 LiDAR 看到 4 个 rack 立柱反射, 但 static map 上
    rack 区域是 free → likelihood field 没解 → 漂.
    画 rack: 364×144 mm 实心矩形 4 个 (A/B/C/D 中心同 rack_positions.py).
    nav planner 绕 rack 是预期 (inflation_radius 0.20m 把 rack 周围都占满). NAV_TO_RACK
    goal 在 rack 前 0.30m, 距 rack 边 0.228m > 0.20 inflation → planner 仍能到.
    APPROACH_RACK 后续要改 raw cmd_vel forward 钻进 (绕过 Nav2).
    map_pgm 在 .gitignore, 仅 yaml + py 进 commit. 推到 Pi5 ~/maps/gamefiel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
2026-04-26 mission_fsm: /initialpose 改 BEST_EFFORT+VOLATILE QoS (AMCL sub 用这个) + retry 7x
2026-04-26 rack_positions: START_POINT 改 zone 中心 (1.000, 0.295) + yaw 沿对角线 0.644 rad
2026-04-26 rack_positions: START_POINT 改 zone 中心 (1.000, 0.295) + yaw 朝 (600,600) 左上角 = 2.498 rad
2026-04-26 nav2_params: 激进档 desired_lin 0.4→0.6, rotate_ang 0.8→1.5, min_approach 0.15→0.20
2026-04-26 nav2_params: 禁 regulated_linear_scaling (rack inflation 砍 linear 到 0)
2026-04-26 mission_fsm: _log_writer 也提前到 sub 之前 init (跟 _qr_seen 同样问题)
2026-04-26 odom_tf_broadcaster: BE QoS subscribe /odom_raw (ESP32 factory FW publish BE 不兼容默认 RELIABLE)
2026-04-26 slam_toolbox: 调激进 loop closure (场地小+Mecanum 打滑 odom 噪声大)
2026-04-26 slam_toolbox: 按反馈改 resolution 0.025 + minimum_travel 0.1 + link_match 收紧 + loop_search 3.0/chain 5
2026-04-26 robot_localization EKF 融合 wheel odom + IMU (修 Mecanum 打滑 yaw drift)
    ekf.yaml: odom0=/odom_raw 用 vx+vyaw, imu0=/imu 用 vyaw+ax+ay.
    publish_tf=true, ekf 自己发 odom→base_footprint TF.
    slam_mapping.launch.py + robot_full.launch.py: odom_tf_broadcaster → ekf_node.
    [ekf.yaml]
2026-04-26 qos_bridge_node: BE→RELIABLE 转发 /odom_raw + /imu 给 EKF
2026-04-26 ekf: frequency 30→15Hz (Pi5 CPU 跑不到 30)
2026-04-26 slam_mapping: 撤回 EKF 改造, 回 odom_tf_broadcaster (EKF 没改善 queue full + bias)
2026-04-26 cmd_vel_relay: deadband 放大 (linear<0.15→0.15, angular<0.5→0.5) 跨过 ESP32 motor 死区
2026-04-26 nav2_params: 禁 use_rotate_to_heading (Mecanum 原地转打滑骗 odom, 强制 linear+angular 同时)
2026-04-26 cmd_vel_relay: 强制 linear=0.15 when controller 只发 angular (绕过 RPP 把 linear 砍 0 让车真前进)
2026-04-26 速度降一档: desired_linear 0.6→0.3, deadband linear 0.15→0.1 angular 0.5→0.3
2026-04-26 最慢档: desired_lin 0.15, deadband lin 0.08 ang 0.20, cap MAX_LINEAR=0.15 MAX_ANG=0.5
2026-04-26 teleop_mode: 加 LiDAR 避障 + 改用 qr_detector_node (新 BE 版本) + camera remap
2026-04-26 nav2 bootstrap: auto-fix lifecycle + initialpose
    P0a/P0b 根因 (实测 2026-04-27 凌晨):
    - AMCL 启动等 /initialpose, 没收到 → 不发 map→odom TF
    - controller_server / planner_server configure 阶段需要 map→base_link
    transform, 拿不到 → configure 超时
    - lifecycle_manager_navigation 看到 configure 失败, 整个 navigation
    链卡 inactive [2] 永不 active
    - 没人调 manage_nodes(STARTUP) 重试 → costmap 不发, RViz 红叉
    修法:
    - nav2_bootstrap_node: 启动后发 /initialpose 7x (BE+VOLATILE QoS),
    等 map→base_footprint TF, 调 manage_nodes(STARTUP) 重新激活 nav 链
    - 加进 robot_full.launch.py (比赛主 launch)
    - 新增 nav2_dryrun.launch.py (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
2026-04-27 qr: cv2.imshow 加 _HAS_GUI 守卫, 修远程 SSH 启 Qt xcb abort; regex 限 TM10$; 打印尺寸 75->55mm
    - qr_detector_node.py: 启动时检测 DISPLAY/QT_QPA_PLATFORM, 无 GUI 时跳过 imshow/waitKey/destroyAllWindows.
    regex RACK[A-D]_.+ -> RACK[A-D]_TM10$ 滤掉别队 (AM9L/IU82/2P6L)
    - qr_print_layout.py: 单格 75->55mm 适配新相机 FOV
    - print_sheet.{pdf,png}: 配套重新生成
2026-04-27 qr: revert TM10 收紧, 老师 QR 是 RACK[A-D]_<随机代码> 不是 TM10
    7f16a0e 错误地把 RACK[A-D]_.+ 收紧到 RACK[A-D]_TM10$, 基于
    错误假设 (以为 TM10 是赛事 schema). 实际 TM10 仅是我们队
    本地打印测试用的代码, 老师比赛贴的 QR 是 RACK[A-D]_<老师
    分配的乱码>, 含 IU82/AM9L/2P6L 等其他队伍代码同一 schema.
    此 commit 仅还原 regex, 保留 cv2.imshow 的 _HAS_GUI 守卫.
2026-04-27 qr: 去掉所有内容过滤, pyzbar 解出的任何 QR 都 publish
    之前的 RACK[A-D]_.+ regex 假设老师 QR schema 是 RACK_xxx.
    但实际格式不可知 (可能任意字符串/hash/UUID), 任何 regex 都
    有漏识别风险. 改为不过滤, 把 schema 判断推到下游 mission_fsm.
    附加: evidence 文件名 sanitize, 防止老师乱码含 / : * 等炸文件系统.
2026-05-02 docs: link demo materials
